sm1717/Distributed-Object-Position-Estimation-Using-a-Sensor-Network/esp_code/readme.txt

Aldo, Alessia, pippi, quarto sono i 4 nodi con i sensori di prossimità.
nota: il codice ordinato e commentato è nella cartella pippi.
Laura è il nodo che non partecipa ma serve solo per stampare sul pc nel plot
