sm1717/Distributed-Object-Position-Estimation-Using-a-Sensor-Network/photo/20260603_191936.jpg

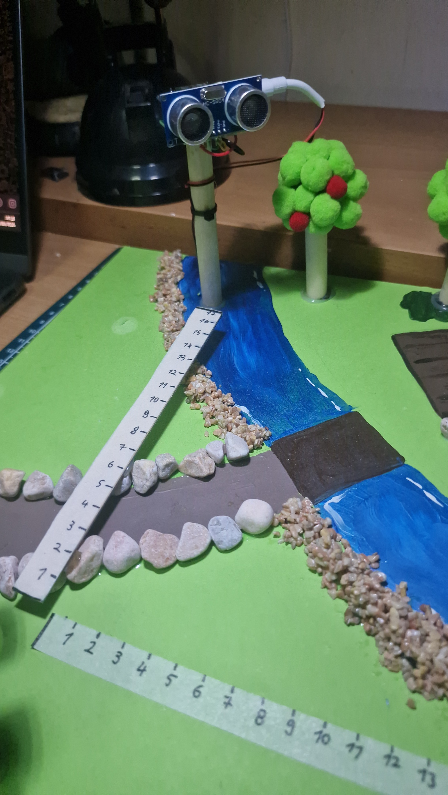
photo/20260603_191936.jpg
